Fudalinm/EmbaddedSystems/README.md

# EmbaddedSystems
Embadded systems course on AGH.
  - Example of real time system that project clock with one spinning arm.
  - Arm RPM is equal to 900.
  - Thera are includes 12 neopixels.
  - Sychronization uses Hall sensor.
  - The arm is powered inductively.
