Fudalinm/EmbaddedSystems/Documentation/pomiary/Pomiar_pradu_10A_na_V .bmp

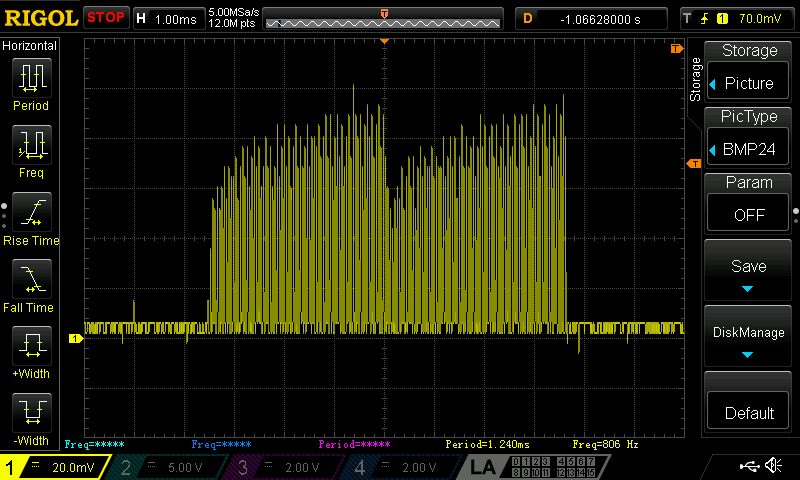
Documentation/pomiary/Pomiar_pradu_10A_na_V .bmp
