Fudalinm/EmbaddedSystems/Documentation/pomiary/Sterowanie_silnikiem_ZMINIONE_KANALY_xL_Z_xH.png

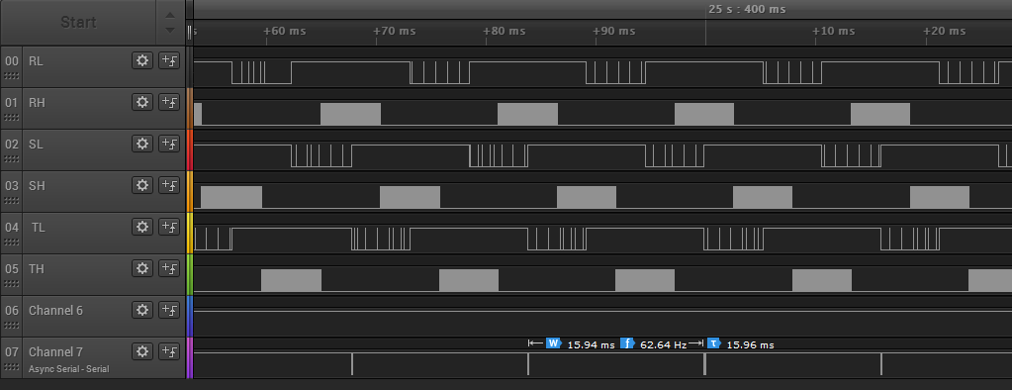
Documentation/pomiary/Sterowanie_silnikiem_ZMINIONE_KANALY_xL_Z_xH.png
