Fudalinm/EmbaddedSystems/src/bldc_cntrl/StartTable.asm

.cseg
;------------------------------------------------------------------------------
; 
;------------------------------------------------------------------------------
;  LSB first
;  
; PWM time  = 31.875 us (510/16000000)
; n = 900 [1/min] = 15 [1/sec]   T = 66.6(6) ms = 66666.6(6) us
; PWM - 0 means max power, 255 means no power
; cycles == 0 - infinity
; cycles == 255 - ramp start method (see document AN1276 created by ST)

TimeTable:
;    time
;     LSB,MSB, cycles ,PWM
.db     0, 15,255,200 	; ON (run motor) - all motor phases energized
.db     0, 10,255,255 	; OFF  - free running
.db     0,150,255,190 	; ON (brake motor and dampening oscillations)
.db     0, 50,255,192 	; ON (brake motor and dampening oscillations)
.db     0, 50,255,194 	; ON (brake motor and dampening oscillations)
.db     0, 50,255,196 	; ON (brake motor and dampening oscillations)
.db     0, 50,255,198 	; ON (brake motor and dampening oscillations)
.db     0, 50,255,200 	; ON (brake motor and dampening oscillations)
.db     0,250,254,255 	; OFF (wait for end of oscillation)

.db     0,  6,254,200 	; ON (run motor) - 2 motor phases energized
.db     0,  6,254,255 	; OFF  - free running
.db     0, 50,254,190 	; ON (brake motor and dampening oscillations)
.db     0, 50,254,192 	; ON (brake motor and dampening oscillations)
.db     0, 50,254,194 	; ON (brake motor and dampening oscillations)
.db     0, 50,254,196 	; ON (brake motor and dampening oscillations)
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
.db  90,0, 6,150 	;
.db  89,0, 7,150 	;
.db  88,0, 7,150 	;
.db  87,0, 7,150 	;
.db  86,0, 7,150 	;
.db  85,0, 7,150 	;
.db  84,0, 7,150 	;
.db  83,0, 7,150 	;
.db  82,0, 8,150 	;
.db  81,0, 8,150 	;
.db  80,0, 8,150 	; --
.db  79,0, 8,150 	;
.db  78,0, 8,150 	;
.db  77,0, 8,150 	;
.db  76,0, 8,150 	;
.db  75,0, 8,150 	;
.db  74,0, 8,150 	;
.db  73,0, 9,150 	;
.db  72,0, 9,150 	;
.db  71,0, 9,150 	;
.db  70,0, 9,150 	; --
.db  69,0, 9,150 	;
.db  68,0,10,150 	;
.db  67,0,10,150 	;
.db  66,0,11,150 	;
.db  65,0,11,150 	;
.db  64,0,11,150 	;
.db  63,0,12,150 	;
.db  62,0,13,150 	;
.db  61,0,15,150 	;
.db  60,0,17,150 	; --
.db  59,0,19,150 	;
.db  58,0,21,150 	;
.db  57,0,23,150 	;
.db  56,0,25,150 	;
.db  55,0,27,150 	;
.db  54,0,29,150 	;
.db  53,0,31,150 	;
.db  52,0,33,150 	;
.db  51,0,35,150 	;
.db  50,0,38,150 	; --
.db  49,0,41,150 	;
.db  48,0,44,150 	;
.db  47,0,48,150 	;
.db  46,0,52,150 	;
.db  45,0,56,150 	;
.db  44,0,61,150 	;
.db  43,0,67,150 	;
.db  42,0,74,150 	;
.db  41,0,82,150 	;
.db  41,0,0,155 	; end marker
.db  41,0,0,155 	; end marker
; .db  41,0,0,155   ; 900 1/min
